BurningBright/nrfmicro/hardware/nrfmicro.kicad_pcb

## KiCad design hardware/nrfmicro.kicad_pcb (2022-10-30)

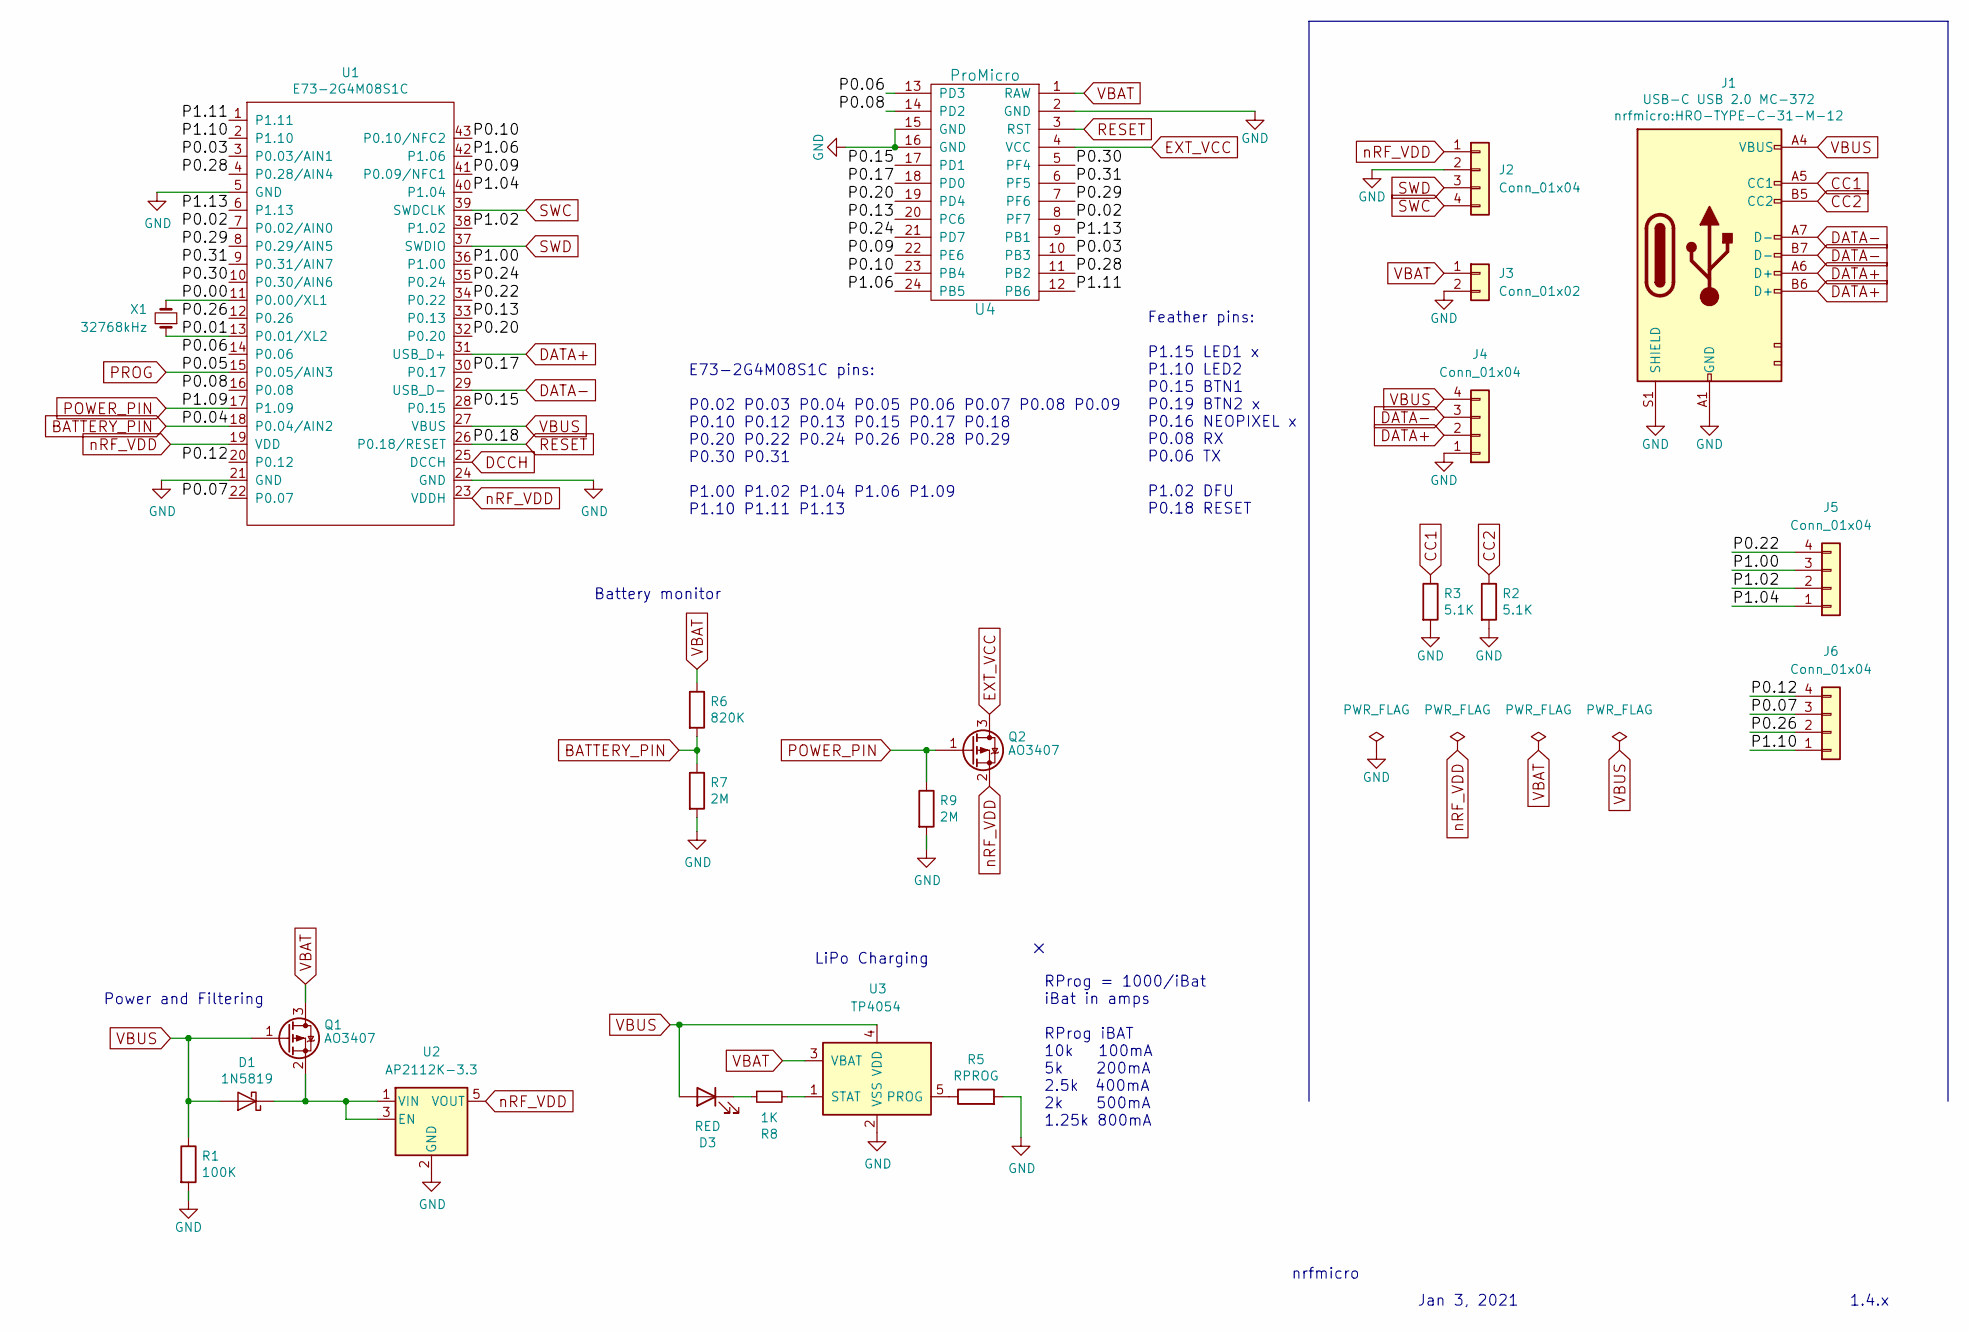
[picture p1: schematic nrfmicro.kicad_sch]

Parts:
D1: 1N5819; D_SOD-323F
D3: RED; LED_0603_1608Metric
J1: USB-C USB 2.0 MC-372; HRO-TYPE-C-31-M-12
J2: Conn_01x04; connector_swd
J3: Conn_01x02
J4: Conn_01x04; connector_usb
J5: Conn_01x04; connector_gpio_1
J6: Conn_01x04; connector_gpio_2
Q1, Q2: AO3407; SOT-23
R1: 100K; R_0603_1608Metric
R2, R3: 5.1K; R_0603_1608Metric
R5: RPROG; R_0603_1608Metric
R6: 820K; R_0603_1608Metric
R7, R9: 2M; R_0603_1608Metric
R8: 1K; R_0603_1608Metric
U1: E73-2G4M08S1C; E73-2G4M08S1C-52840
U2: AP2112K-3.3; SOT-23-5
U3: TP4054; SOT-23-5
U4: ProMicro; pro_micro
X1: 32768kHz

Connections:
/P0.00: U1.11 (P0.00/XL1), X1.2
/P0.01: U1.13 (P0.01/XL2), X1.1
/P0.02: U1.7 (P0.02/AIN0), U4.8 (PF7)
/P0.03: U1.3 (P0.03/AIN1), U4.10 (PB3)
/P0.06: U1.14 (P0.06), U4.13 (PD3)
/P0.07: J6.3, U1.22 (P0.07)
/P0.08: U1.16 (P0.08), U4.14 (PD2)
/P0.09: U1.41 (P0.09/NFC1), U4.22 (PE6)
/P0.10: U1.43 (P0.10/NFC2), U4.23 (PB4)
/P0.12: J6.4, U1.20 (P0.12)
/P0.13: U1.33 (P0.13), U4.20 (PC6)
/P0.15: U1.28 (P0.15), U4.17 (PD1)
/P0.17: U1.30 (P0.17), U4.18 (PD0)
/P0.20: U1.32 (P0.20), U4.19 (PD4)
/P0.22: J5.4, U1.34 (P0.22)
/P0.24: U1.35 (P0.24), U4.21 (PD7)
/P0.26: J6.2, U1.12 (P0.26)
/P0.28: U1.4 (P0.28/AIN4), U4.11 (PB2)
/P0.29: U1.8 (P0.29/AIN5), U4.7 (PF6)
/P0.30: U1.10 (P0.30/AIN6), U4.5 (PF4)
/P0.31: U1.9 (P0.31/AIN7), U4.6 (PF5)
/P1.00: J5.3, U1.36 (P1.00)
/P1.02: J5.2, U1.38 (P1.02)
/P1.04: J5.1, U1.40 (P1.04)
/P1.06: U1.42 (P1.06), U4.24 (PB5)
/P1.10: J6.1, U1.2 (P1.10)
/P1.11: U1.1 (P1.11), U4.12 (PB6)
/P1.13: U1.6 (P1.13), U4.9 (PB1)
BATTERY_PIN: R6.2, R7.1, U1.18 (P0.04/AIN2)
CC1: J1.A5 (CC1), R3.1
CC2: J1.B5 (CC2), R2.1
DATA+: J1.A6 (D+), J1.B6 (D+), J4.2, U1.31 (USB_D+)
DATA-: J1.A7 (D-), J1.B7 (D-), J4.3, U1.29 (USB_D-)
DCCH: U1.25 (DCCH)
EXT_VCC: Q2.3 (D), U4.4 (VCC)
GND: J1.A1 (GND), J1.S1 (SHIELD), J2.2, J3.2, J4.1, R1.2, R2.2, R3.2, R5.2, R7.2, R9.2, U1.5 (GND), U1.21 (GND), U1.24 (GND), U2.2 (GND), U3.2 (VSS), U4.2 (GND), U4.15 (GND), U4.16 (GND)
unnamed: D1.1 (K), Q1.2 (S), U2.1 (VIN), U2.3 (EN)
unnamed: D3.1 (K), R8.1
unnamed: R5.1, U3.5 (PROG)
unnamed: R8.2, U3.1 (STAT)
POWER_PIN: Q2.1 (G), R9.1, U1.17 (P1.09)
PROG: U1.15 (P0.05/AIN3)
RESET: U1.26 (P0.18/RESET), U4.3 (RST)
SWC: J2.4, U1.39 (SWDCLK)
SWD: J2.3, U1.37 (SWDIO)
VBAT: J3.1, Q1.3 (D), R6.1, U3.3 (VBAT), U4.1 (RAW)
VBUS: D1.2 (A), D3.2 (A), J1.A4 (VBUS), J4.4, Q1.1 (G), R1.1, U1.27 (VBUS), U3.4 (VDD)
nRF_VDD: J2.1, Q2.2 (S), U1.19 (VDD), U1.23 (VDDH), U2.5 (VOUT)

Notes on the sheet:
LiPo Charging
Jan 3, 2021
1.4.x
RProg = 1000/iBat iBat in amps RProg iBAT 10k 100mA 5k 200mA 2.5k 400mA 2k 500mA 1.25k 800mA
Power and Filtering
nrfmicro
Battery monitor
E73-2G4M08S1C pins: P0.02 P0.03 P0.04 P0.05 P0.06 P0.07 P0.08 P0.09 P0.10 P0.12 P0.13 P0.15 P0.17 P0.18 P0.20 P0.22 P0.24 P0.26 P0.28 P0.29 P0.30 P0.31 P1.00 P1.02 P1.04 P1.06 P1.09 P1.10 P1.11 P1.13
Feather pins: P1.15 LED1 x P1.10 LED2 P0.15 BTN1 P0.19 BTN2 x P0.16 NEOPIXEL x P0.08 RX P0.06 TX P1.02 DFU P0.18 RESET

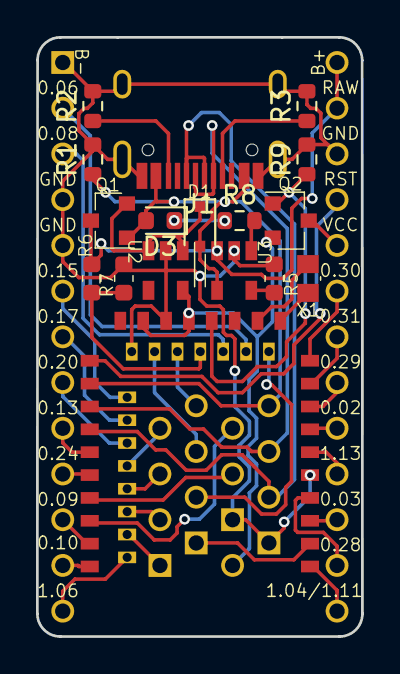
[picture p2: board nrfmicro.kicad_pcb from above]

Board: 2 copper layers, 18.1 x 33.3 mm, 23 parts (0 on the bottom side), 46 nets.
